Aus3D/StepstickTester/Project Outputs for StepstickTester/stepstickTester.TXT

M48
;Layer_Color=9474304
;FILE_FORMAT=4:4
METRIC
;TYPE=PLATED
T1F00S00C0.3500
T2F00S00C0.4000
T3F00S00C0.9000
T4F00S00C0.9652
T5F00S00C1.0160
T6F00S00C1.2000
T7F00S00C1.8000
T8F00S00C3.2000
T9F00S00C3.8100
%
T01
X01000000Y00050000
X01100000
X01200000
X01300000
X00900000
X00800000
X00700000
X00600000
X00500000
X00400000
X00300000
X00150000Y00350000
X00250000
X00350000
X00450000
X00550000
Y00150000
X00450000
X00400000Y00250000
X00300000Y00450000
X00600000
X00650000Y00350000
X00750000
X00850000
X00900000Y00450000
X00800000
X00850000Y00150000
X00950000
X00750000
X00650000
X01050000
X01150000
X01250000
X01350000
X01300000Y00250000
X01350000Y00350000
X01250000
X01150000
X01200000Y00450000
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
