Aus3D/StepstickTester/Project Outputs for StepstickTester/StepstickTester_v1a_bom.xlsx

Designator | Comment | Description | Value | LibRef | Manufacturer 1 | Manufacturer Part Number 1 | Quantity | Supplier 1 | Supplier Part Number 1 | Substitute
BZ1 | 5V Buzzer, 6.5mm TH leads | Speaker, Magnetic Transducer |  | BZ_12x8.5x6.5_2kHz | CUI Inc (https://octopart-clicks.com/click/altium?sku=102-1152-ND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) | CEM-1201(50) (https://octopart-clicks.com/click/altium?sku=102-1152-ND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) | 1 | Digi-Key | 102-1152-ND (https://octopart-clicks.com/click/altium?sku=102-1152-ND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) | Sub OK
C1, C8, C9, C10 | CapC-0603-100nF | Capacitor (Semiconductor SIM Model) | 100nF | CapC-0603-100nF | Yageo (https://octopart-clicks.com/click/altium?sku=311-1344-1-ND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) | CC0603KRX7R9BB104 (https://octopart-clicks.com/click/altium?sku=311-1344-1-ND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) | 4 | Digi-Key | 311-1344-1-ND (https://octopart-clicks.com/click/altium?sku=311-1344-1-ND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) | Sub OK
C2, C3 | CapE-6.3-100uF-35V | Polarized Capacitor (Surface Mount) | 100uF 35V | CapE-6.3-100uF-35V | Panasonic Electronic Components (https://octopart-clicks.com/click/altium?manufacturer=Panasonic%20Electronic%20Components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) | EEE-FT1V101AP (https://octopart-clicks.com/click/altium?manufacturer=Panasonic%20Electronic%20Components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) | 2 | Digi-Key | PCE5016CT-ND (https://octopart-clicks.com/click/altium?manufacturer=Panasonic%20Electronic%20Components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) | Sub OK
C4, C6, C7 | CapC-0603-1uF 50V | Capacitor (Semiconductor SIM Model) | 1uF | CapC-0603-1uF 50V | Samsung Electro-Mechanics (https://octopart-clicks.com/click/altium?manufacturer=Samsung%20Electro-Mechanics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) | CL10A105KB8NNNC (https://octopart-clicks.com/click/altium?manufacturer=Samsung%20Electro-Mechanics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) | 3 | Digi-Key | 1276-1860-1-ND (https://octopart-clicks.com/click/altium?manufacturer=Samsung%20Electro-Mechanics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) | Sub OK
C5, C12 | CapC-0603-4.7uF | Capacitor (Semiconductor SIM Model) | 4.7uF | CapC-0603-4.7uF | Yageo (https://octopart-clicks.com/click/altium?sku=311-1521-1-ND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) | CC0603KRX5R5BB475 (https://octopart-clicks.com/click/altium?sku=311-1521-1-ND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) | 2 | Digi-Key | 311-1521-1-ND (https://octopart-clicks.com/click/altium?sku=311-1521-1-ND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) | Sub OK
C11 | CapC-1210-4.7uF-50V | Capacitor (Semiconductor SIM Model) | 4.7uF | CapC-1210-4.7uF-50V | Murata Electronics North America (https://octopart-clicks.com/click/altium?sku=490-1864-1-ND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) | GRM32ER71H475KA88L (https://octopart-clicks.com/click/altium?sku=490-1864-1-ND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) | 1 | Digi-Key | 490-1864-1-ND (https://octopart-clicks.com/click/altium?sku=490-1864-1-ND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) | Sub OK
D1, D2, D3 | Diode Schottky 2A 40V | Default Diode |  | Diode Schottky 2A 40V | Panasonic Electronic Components (https://octopart-clicks.com/click/altium?manufacturer=Panasonic%20Electronic%20Components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) | DB2W40200L (https://octopart-clicks.com/click/altium?manufacturer=Panasonic%20Electronic%20Components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) | 3 | Digi-Key | DB2W40200LCT-ND (https://octopart-clicks.com/click/altium?manufacturer=Panasonic%20Electronic%20Components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) | Sub OK
F1, F2 | PTC Resettable Fuse | Fuse - 30V 400mA Trip PTC SMD 1206 | 200mA | Fuse - 30V 400mA Trip PTC SMD 1206 | Bel Fuse Inc. (https://octopart-clicks.com/click/altium?sku=507-1797-1-ND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) | 0ZCJ0020FF2E (https://octopart-clicks.com/click/altium?sku=507-1797-1-ND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) | 2 | Digi-Key | 507-1797-1-ND (https://octopart-clicks.com/click/altium?sku=507-1797-1-ND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) | Sub OK
L1 | Inductor SMD 33uH 2.5A | MagneticCore Inductor with Winding Polarity Marking | 33uH | Inductor SMD 33uH 2.5A | Bourns Inc. (https://octopart-clicks.com/click/altium?sku=SRN6045TA-330MCT-ND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) | SRN6045TA-330M (https://octopart-clicks.com/click/altium?sku=SRN6045TA-330MCT-ND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) | 1 | Digi-Key | SRN6045TA-330MCT-ND (https://octopart-clicks.com/click/altium?sku=SRN6045TA-330MCT-ND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) | Sub OK
LD1, LD2, LD3, LD4, LD5 | GREEN | Hyper-Bright LED |  | LEDG 0603 | Lite-On Inc. (https://octopart-clicks.com/click/altium?sku=160-1435-2-ND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) | LTST-C190KGKT (https://octopart-clicks.com/click/altium?sku=160-1435-2-ND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) | 5 | Digi-Key | 160-1435-2-ND (https://octopart-clicks.com/click/altium?sku=160-1435-2-ND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) | Sub OK
LD6 | RED | Hyper-Bright LED |  | LEDR 0603 | Lite-On Inc. (https://octopart-clicks.com/click/altium?sku=160-1435-2-ND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) | LTST-C190KGKT (https://octopart-clicks.com/click/altium?sku=160-1435-2-ND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) | 1 | Digi-Key | 160-1435-2-ND (https://octopart-clicks.com/click/altium?sku=160-1435-2-ND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) | Sub OK
Q1, Q2 | DMP3099L-7 | MOSFET SMD P-CH 20V 3.8A SOT-23-3 |  | MOSFET SMD P-CH 20V 3.8A TSOT-23-6 | Diodes Incorporated (https://octopart-clicks.com/click/altium?sku=DMP3099L-7DICT-ND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) | DMP3099L-7 (https://octopart-clicks.com/click/altium?sku=DMP3099L-7DICT-ND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) | 2 | Digi-Key | DMP3099L-7DICT-ND (https://octopart-clicks.com/click/altium?sku=DMP3099L-7DICT-ND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) | Sub OK
R1, R3, R9, R21 | Res-0603-10K | Resistor | 10K | Res-0603-10K | Yageo (https://octopart-clicks.com/click/altium?sku=311-10.0KHRCT-ND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) | RC0603FR-0710KL (https://octopart-clicks.com/click/altium?sku=311-10.0KHRCT-ND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) | 4 | Digi-Key | 311-10.0KHRCT-ND (https://octopart-clicks.com/click/altium?sku=311-10.0KHRCT-ND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) | Sub OK
R2, R16, R17, R19, R25 | Res-0603-4K7 | Resistor | 4.7K | Res-0603-4K7 | Yageo (https://octopart-clicks.com/click/altium?sku=311-4.7KGRCT-ND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) | RC0603JR-074K7L (https://octopart-clicks.com/click/altium?sku=311-4.7KGRCT-ND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) | 5 | Digi-Key | 311-4.7KGRCT-ND (https://octopart-clicks.com/click/altium?sku=311-4.7KGRCT-ND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) | Sub OK
R4 | Res-0603-54K9 | Resistor | 54.9k | Res-0603-10K | Yageo (https://octopart-clicks.com/click/altium?sku=311-10.0KHRCT-ND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) | RC0603FR-0710KL (https://octopart-clicks.com/click/altium?sku=311-10.0KHRCT-ND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) | 1 | Digi-Key | 311-10.0KHRCT-ND (https://octopart-clicks.com/click/altium?sku=311-10.0KHRCT-ND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) | Sub OK
R5, R6, R7, R8, R18, R20, R23, R24, R26 | Res-0603-1K | Resistor | 1K | Res-0603-1K | Yageo (https://octopart-clicks.com/click/altium?sku=311-1.00KHRCT-ND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) | RC0603FR-071KL (https://octopart-clicks.com/click/altium?sku=311-1.00KHRCT-ND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) | 9 | Digi-Key | 311-1.00KHRCT-ND (https://octopart-clicks.com/click/altium?sku=311-1.00KHRCT-ND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) | Sub OK
R10, R11, R12, R13, R14, R15 | Thick Film | Resistor SMD chip 470 Ohm 0.1W 5% 0603 | 470R | RES_470R_0603_5% | Vishay/Dale (https://octopart-clicks.com/click/altium?sku=541-470GCT-ND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) | CRCW0603470RJNEA (https://octopart-clicks.com/click/altium?sku=541-470GCT-ND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) | 6 | Digi-Key | 541-470GCT-ND (https://octopart-clicks.com/click/altium?sku=541-470GCT-ND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) | Sub OK
R22 | Res-0603-100R | Resistor | 100R | Res-0603-100R | Yageo (https://octopart-clicks.com/click/altium?sku=311-100HRCT-ND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) | RC0603FR-07100RL (https://octopart-clicks.com/click/altium?sku=311-100HRCT-ND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) | 1 | Digi-Key | 311-100HRCT-ND (https://octopart-clicks.com/click/altium?sku=311-100HRCT-ND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) | Sub OK
U1 | AOZ1282CI |  |  | Buck Regulator AOZ1282CI | Alpha & Omega Semiconductor Inc. (https://octopart-clicks.com/click/altium?sku=785-1613-1-ND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) | AOZ1282CI (https://octopart-clicks.com/click/altium?sku=785-1613-1-ND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) | 1 | Digi-Key | 785-1613-1-ND (https://octopart-clicks.com/click/altium?sku=785-1613-1-ND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)
