Aus3D/StepstickTester/case-test-assembly.SLDASM

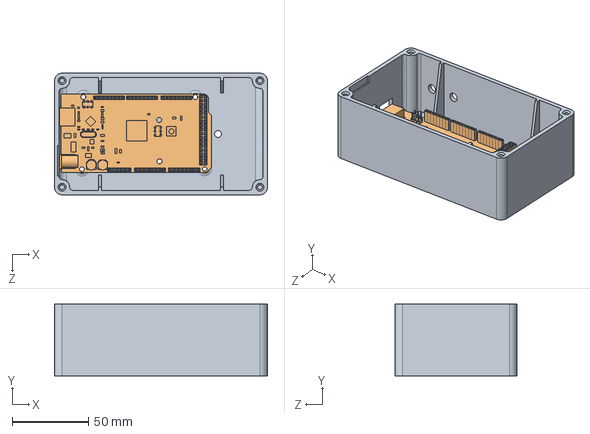
[picture p1: CAD file, 2018-09-07]
case-test-assembly.SLDASM
140.0 x 47.0 x 80.0 mm
case
ArduinoMega2560
