Aus3D/StepstickTester/case.SLDPRT

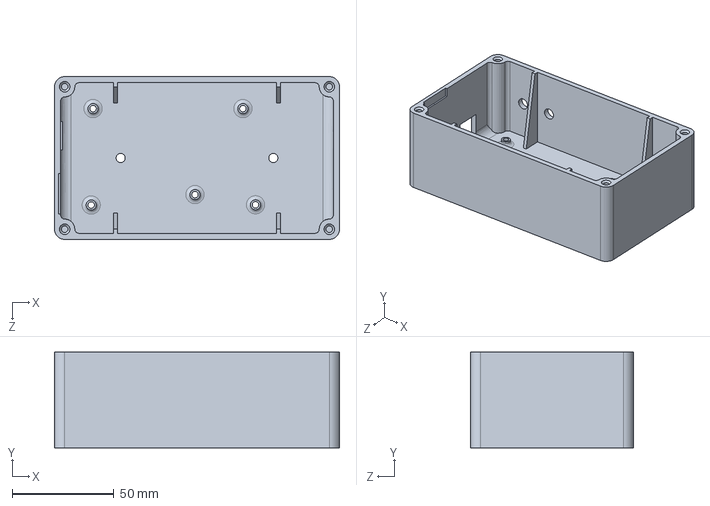
[picture p2: CAD file, 2018-09-07]
case.SLDPRT
140.0 x 47.0 x 80.0 mm
