Aus3D/StepstickTester/StepstickTester.pdf

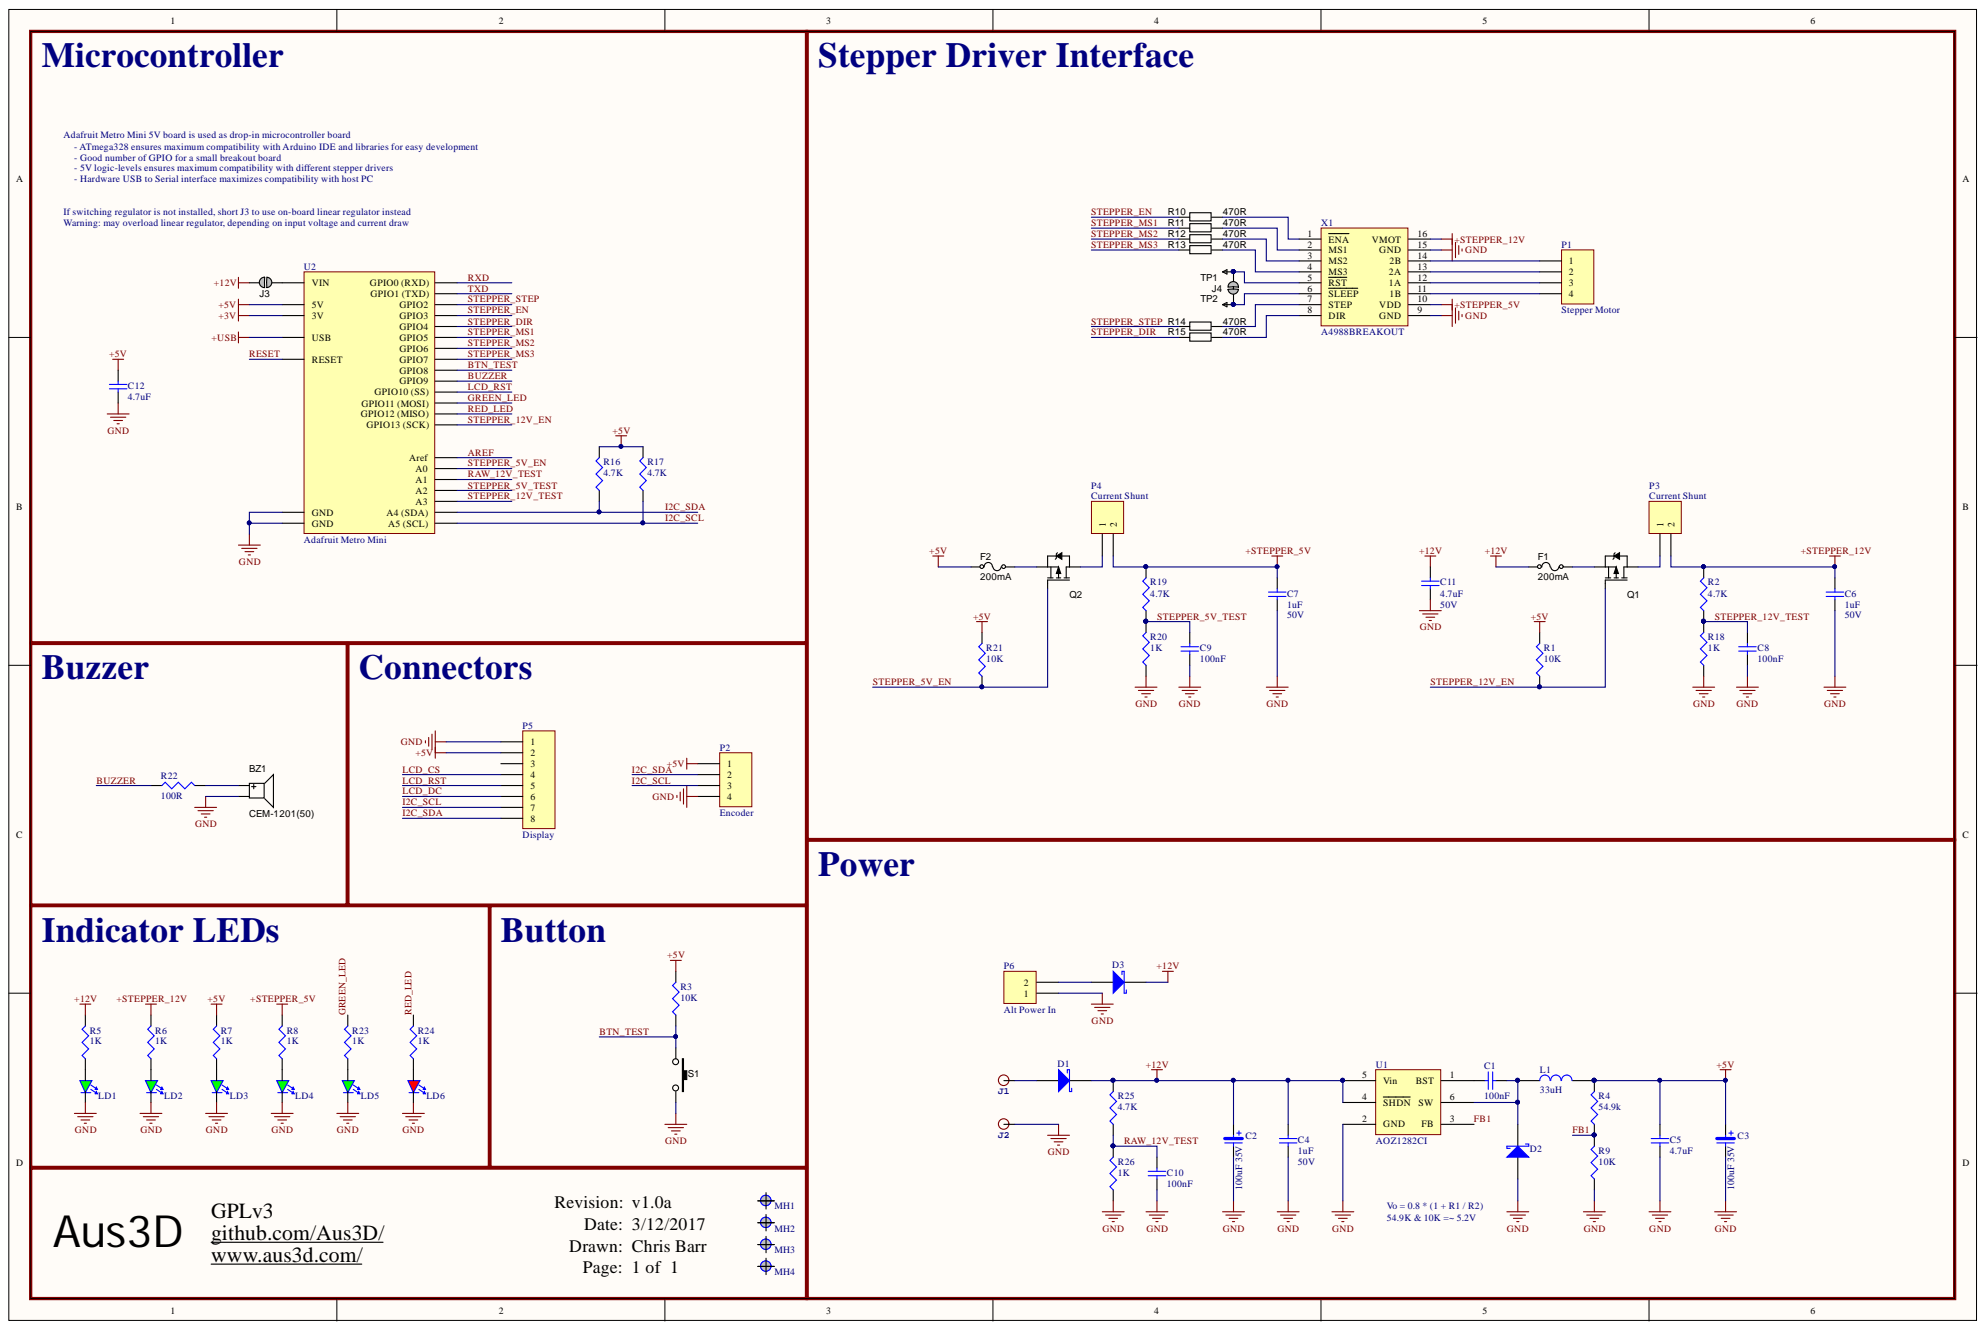
[picture p3: page 1]

Adafruit Metro Mini 5V board is used as drop-in microcontroller board
- ATmega328 ensures maximum compatibility with Arduino IDE and libraries for easy development
- Good number of GPIO for a small breakout board
- 5V logic-levels ensures maximum compatibility with different stepper drivers
- Hardware USB to Serial interface maximizes compatibility with host PC

If switching regulator is not installed, short J3 to use on-board linear regulator instead
Warning: may overload linear regulator, depending on input voltage and current draw

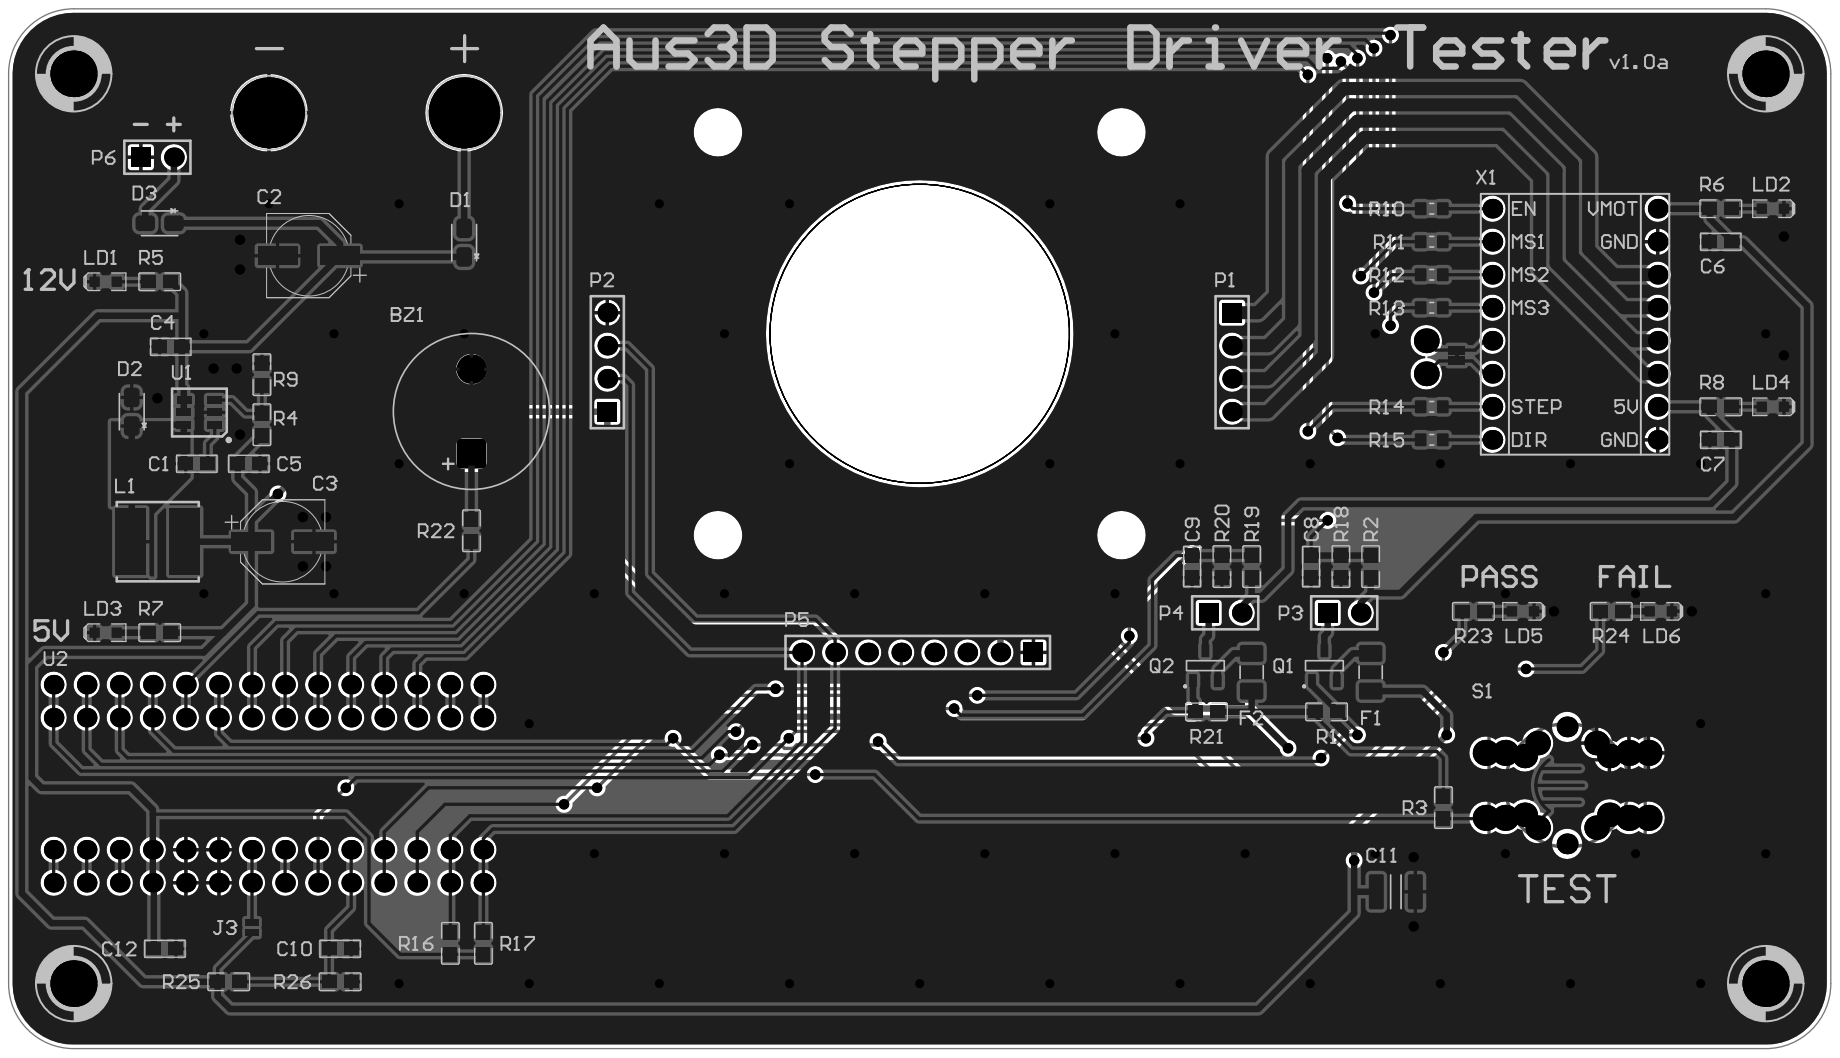
[picture p4: page 2]
