Aus3D/StepstickTester/(list of files, drawings)

Other design files:
stepstickTester.PcbDoc
StepstickTester.PrjPcb
stepsticktester.SchDoc
