Aus3D/StepstickTester/(commit log)

2017-12-04 Initial version
    [StepstickTester.PrjPcb, StepstickTester_v1a_bom.xlsx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]
2018-02-23 Improve step generation
    Only calculate step delay once per motion instead of each step
    Shorten step pulse length
    [stepper.cpp]
2018-02-23 Update pinout to match PCB
2018-02-23 LEDs and buzzer
2018-02-23 Add and enable AS5600 I2C encoder
2018-02-23 Correct voltage divider equation
    [stepstickTesterSketch.ino]
2018-02-23 Enable 5V voltage read
2018-02-23 Display test failure on screen too
    [stepstickTesterSketch.ino]
2018-02-23 Increase motor test speed
2018-02-23 Rename and tidy stepper test defines
2018-02-23 Tidy 5V and 12V line tests
2018-02-23 Can change driver type
2018-02-23 Named driver types, selection menu, motor encoder as input knob
2018-02-24 Check input voltage, test '12V' relative to that
2018-02-24 Display input power test results
2018-02-24 Change menu buzzer sound
    [stepstickTesterSketch.ino]
2018-02-24 Refresh display on startup
    Prevents static or old buffer displaying on startup/reset
    [stepstickTesterSketch.ino]
2018-02-24 Rename power-related defines
2018-02-24 Fix strings not in progmem
    [stepstickTesterSketch.ino]
2018-02-25 Optimise stepper memory usage
    Pack microstepping enable pin status into single byte, rather than separate booleans. Saves 2 * microstepping modes bytes per stepper driver type.
2018-02-25 Move driver types into struct
2018-02-25 Initial generic menu work
    Working so far, but running too low on memory - instability and can't add many entries. Need to reduce RAM usage.
    [stepper.cpp, stepper.h, stepstickTesterSketch.ino]
2018-02-25 Add dimensions to PCB
    [StepstickTester.PrjPcb, stepstickTester.PcbDoc]
2018-02-25 3D printed case
    [case-test-assembly.SLDASM, case.SLDPRT]
2018-02-27 Redo display, reduce RAM, implement menu more fully
    Swap from Adafruit library to SSD1306Ascii library for OLED display. No longer buffering display in RAM regains a lot of space, but some text rendering had to be reworked.
    Flesh out menu structure and implementation now that RAM is available.
    [stepstickTesterSketch.ino]
2018-02-27 Encoder polarity
    Encoder polarity shouldn't matter in stepper tests, and direction can be inverted for use in menu.
    [config.h, stepstickTesterSketch.ino]
2018-02-27 Make tests configurable per driver type
    Each driver has an associated test procedure containing pointers to each function that should be run during testing. This should allow adding or excluding specific test behaviour for certain drivers if needed.
2018-03-21 v2.0 initial changes
    Schematic basically finished, some initial changes to PCB.
    [StepstickTester.PrjPcb, stepstickTester.PcbDoc, stepsticktester.SchDoc]
2019-05-18 Make 5V & 12V down seperate tests
    5V down fails for TMC2100 as the internal regulator keeps the rail high. Checking separately from power down allows more flexibility.
    [stepper.cpp, tests.cpp, tests.h]
